hansake/Z80_Computer/hardware/README.md

Useful information about Z80 and its peripherals:
- [Z80 CPU User Manual - um0080.pdf](http://www.zilog.com/docs/z80/um0080.pdf)
- [perip.book - um0081.pdf](http://www.zilog.com/docs/z80/um0081.pdf)

The schematic and component placement is created with KiCad: https://www.kicad.org/
