hansake/Z80_Computer/photos/README.md

Some photos of the Z80 computer board and test environment.
(some photos with the SPI/SD card interface should be added)
