hansake/Z80_Computer/PLD/README.md

The address decoding is done with a Programmable Logic Device (PLD).
The device is ATF22V10C and the logic design is made and simulated
with WinCUPL: https://www.microchip.com/en-us/products/fpgas-and-plds/spld-cplds/pld-design-resources

My setup runs WinCUPL in Wine (https://www.winehq.org/) using PlayOnLinux (https://www.playonlinux.com/en/) on Linux Mint.

To program the ATF22V10C I used a home built device called afterburner described in: https://github.com/ole00/afterburner

PLD programmer: [hansake/PLD_programmer: GAL/PLD programmer used to program Atmel ATF22V10 and ATF16V8.](https://github.com/hansake/PLD_programmer)
