hansake/Z80_Computer/hardware/KiCad/README.md

The design files are exported by KiCad as a zip file.
