hansake/Z80_Computer/photos/Z80_SPI_SD_card_speed.png

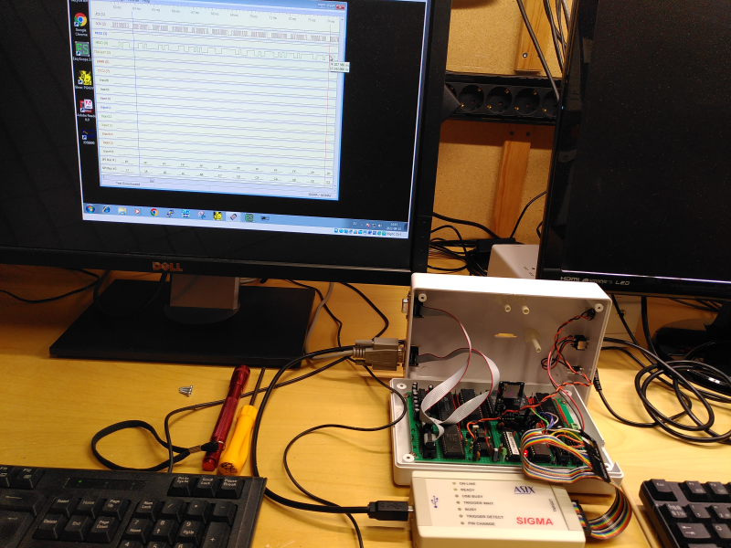
photos/Z80_SPI_SD_card_speed.png
