hansake/Z80_Computer/PLD/Z80_winsim_2021-07-27.png

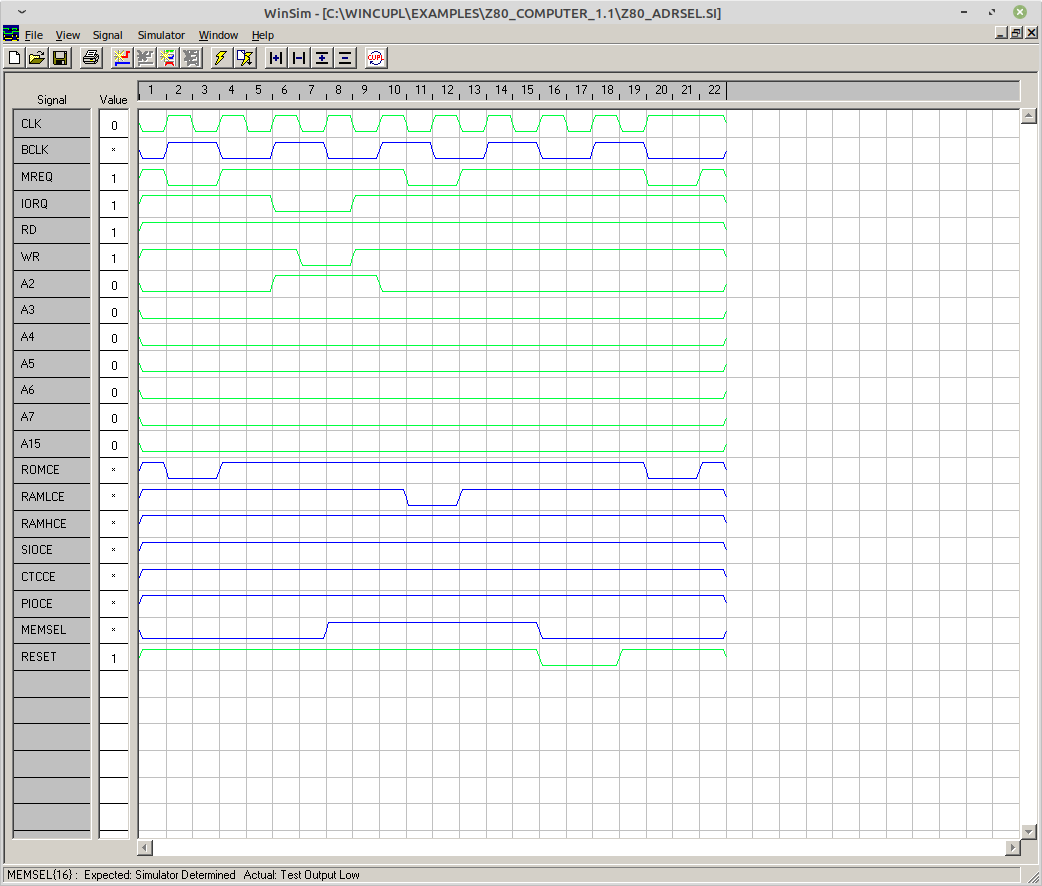
PLD/Z80_winsim_2021-07-27.png
