hansake/Z80_Computer/photos/Z80_SD_tests.png

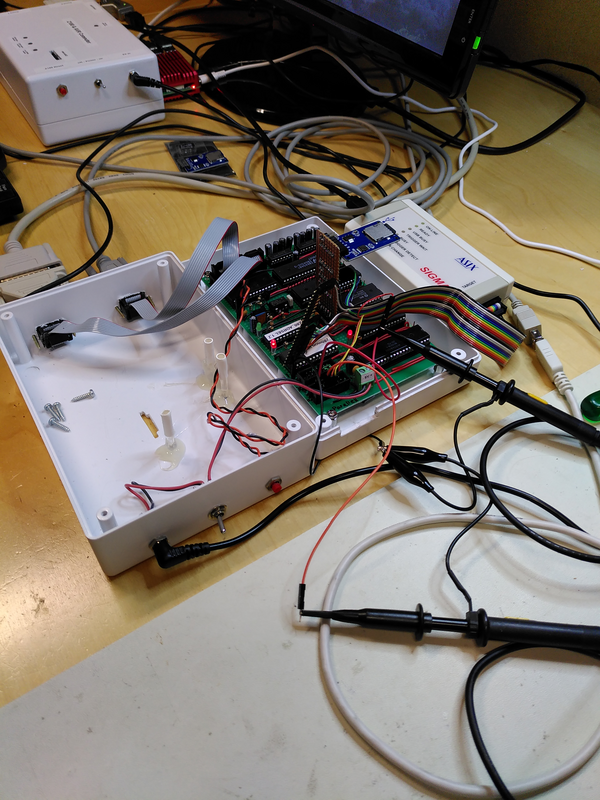
photos/Z80_SD_tests.png
