hansake/Z80_Computer/hardware/Z80_computer_layout.pdf

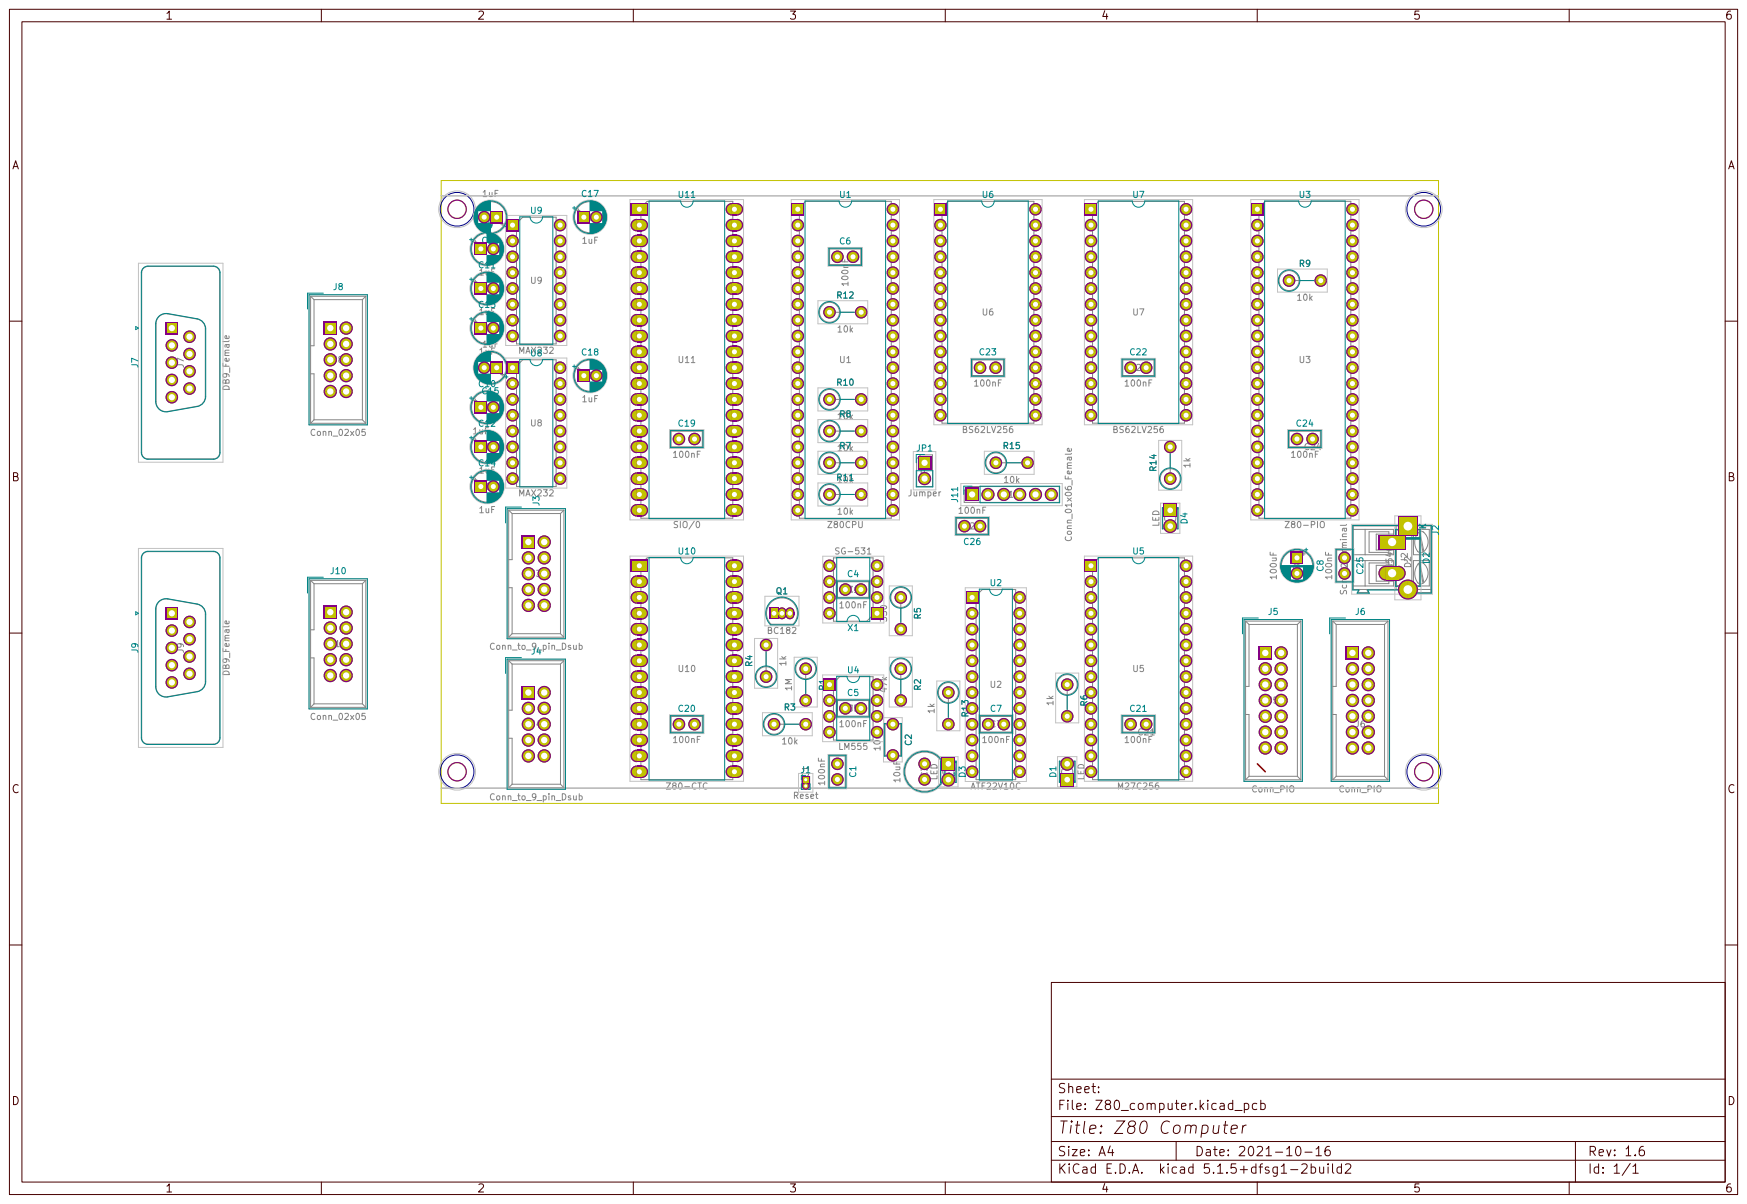
[picture p5: page 1]
