hansake/Z80_Computer/hardware/Z80_computer_schematic.pdf

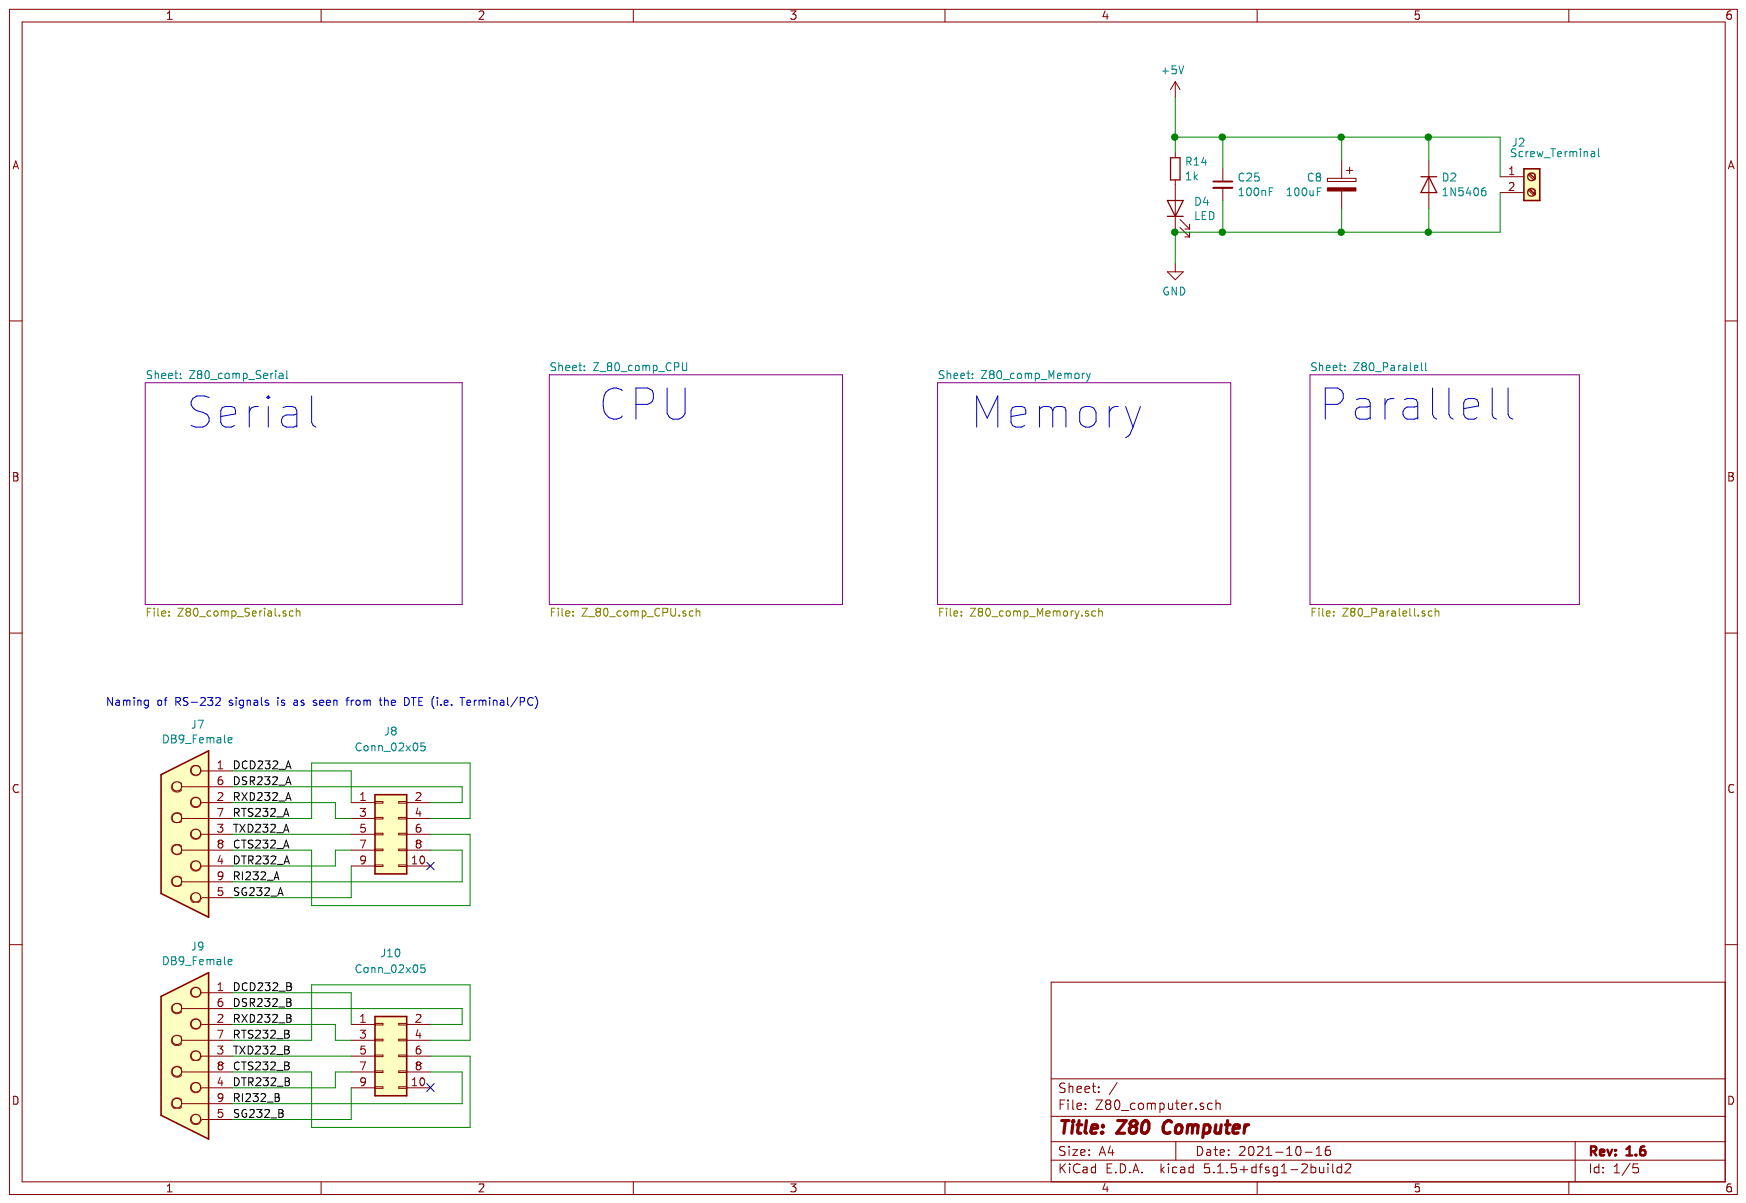
[picture p6: page 1]

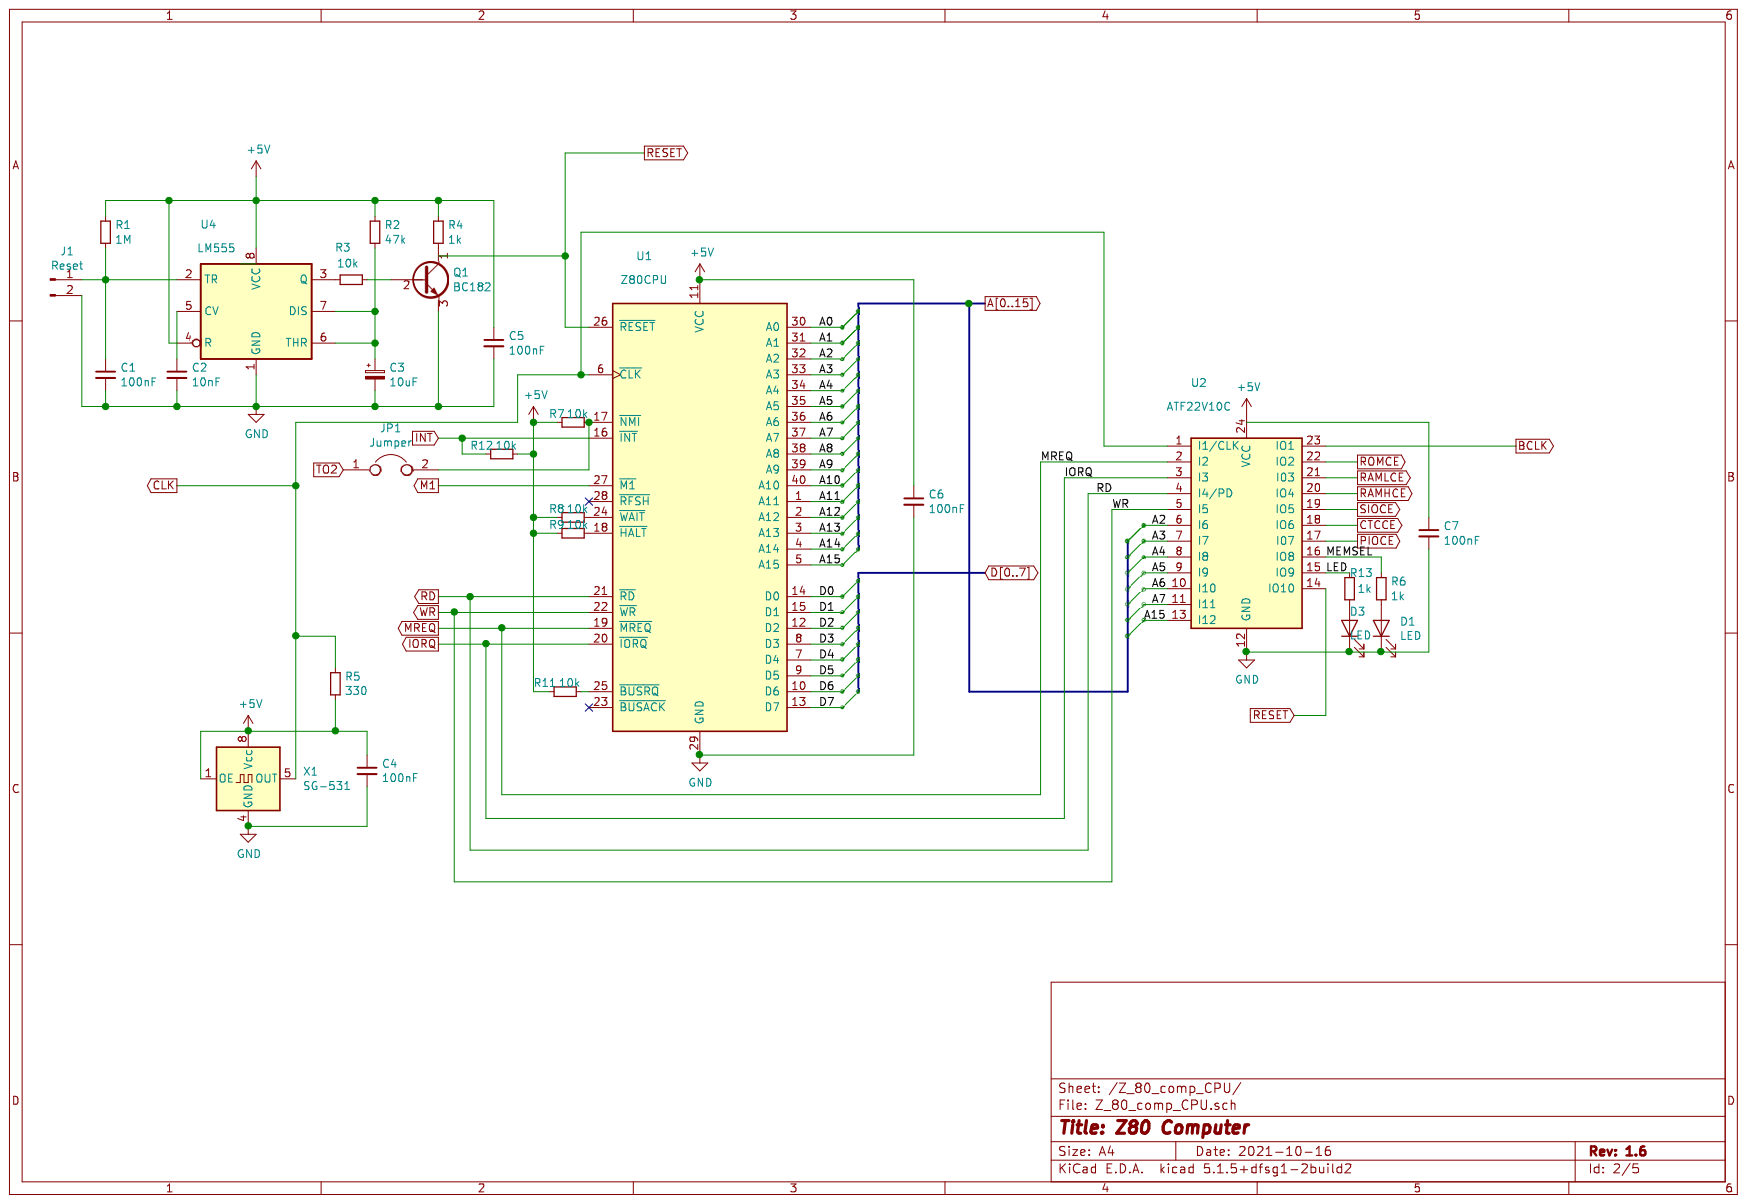
[picture p7: page 2]

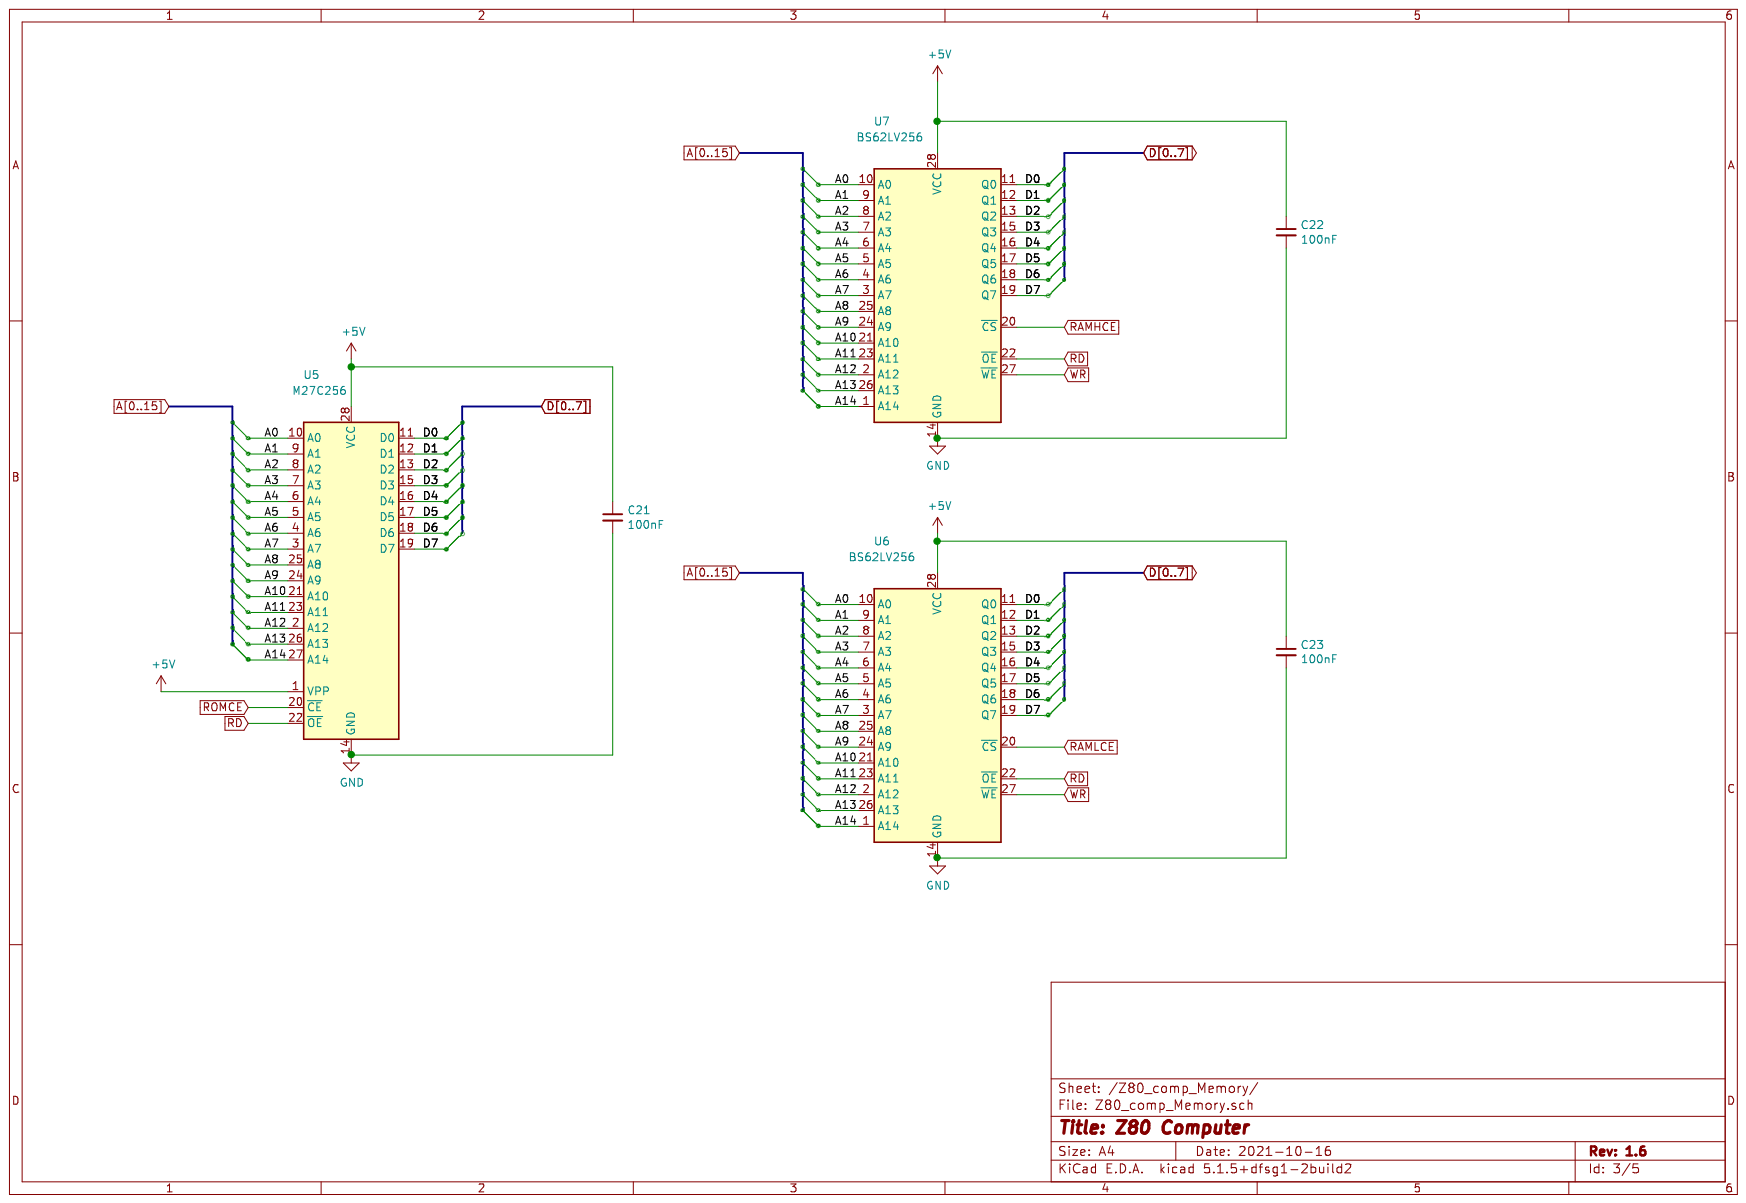
[picture p8: page 3]

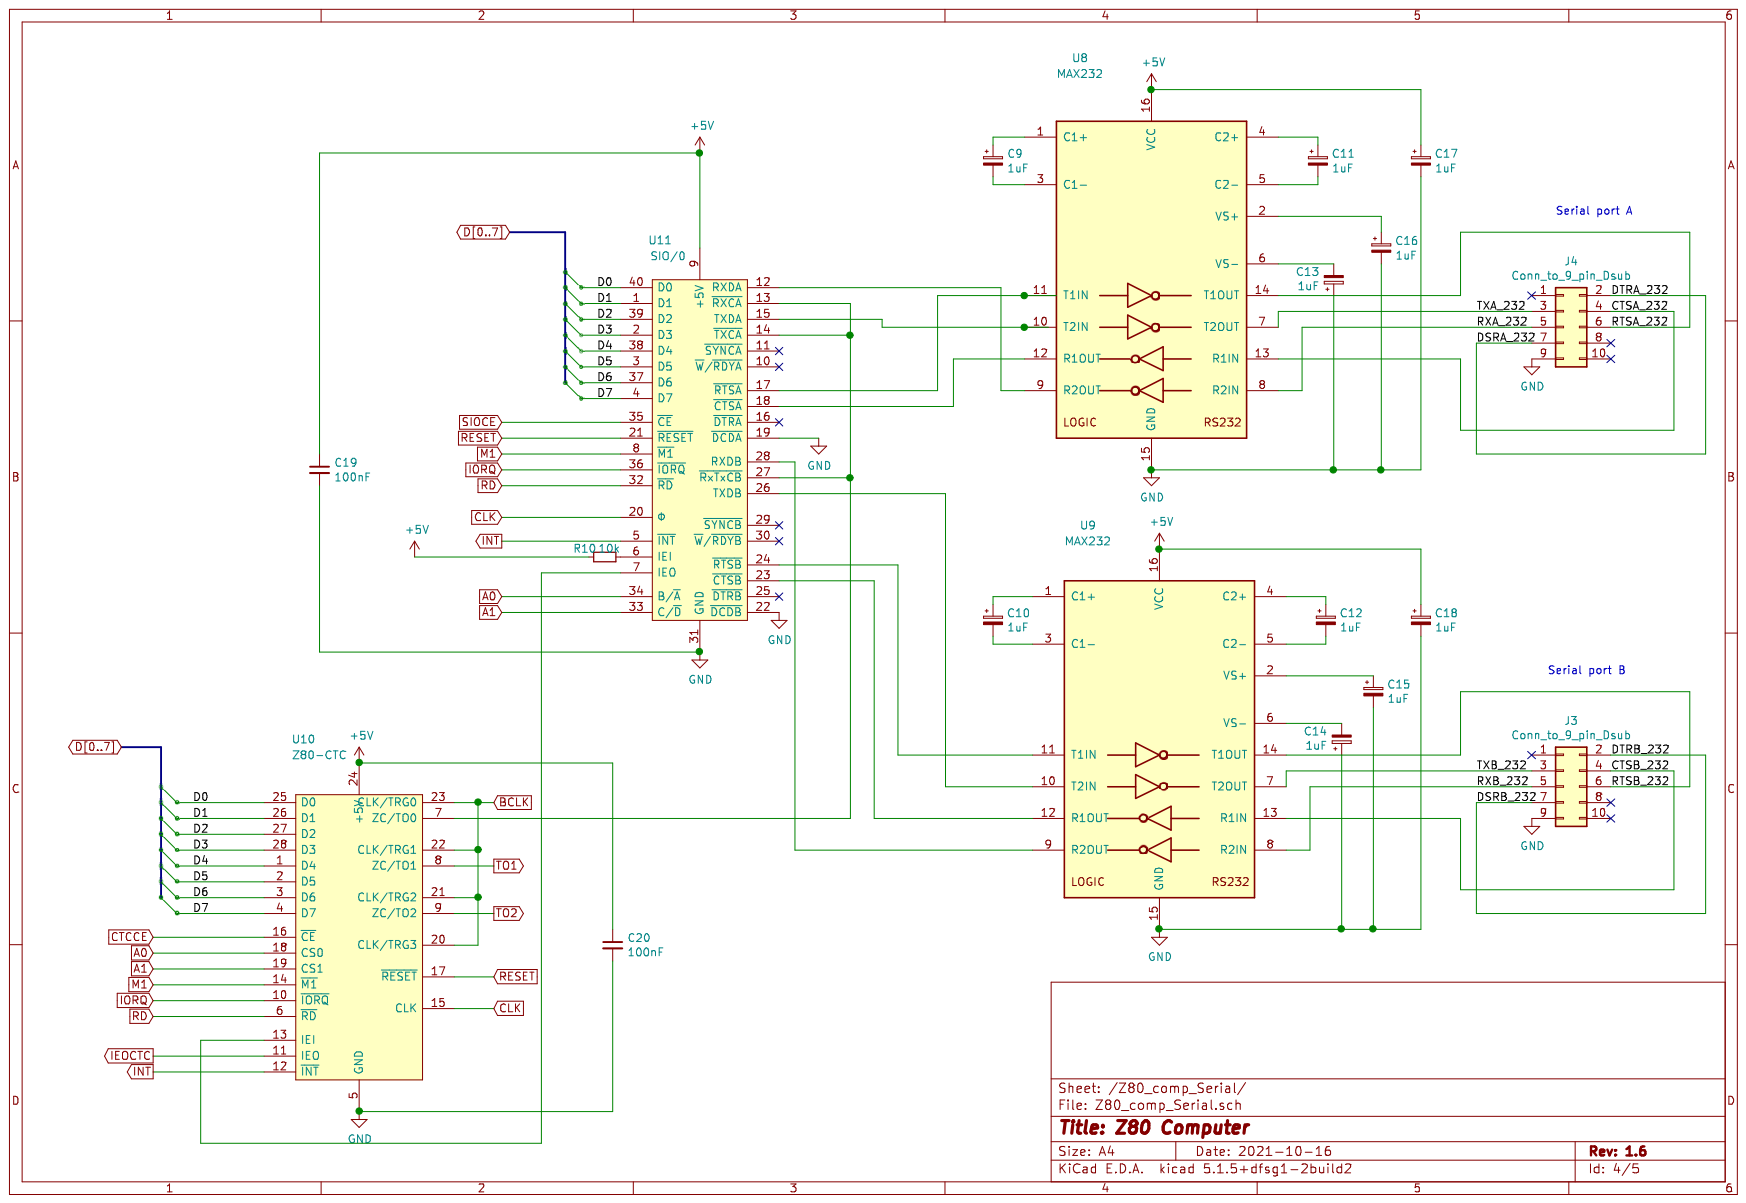
[picture p9: page 4]

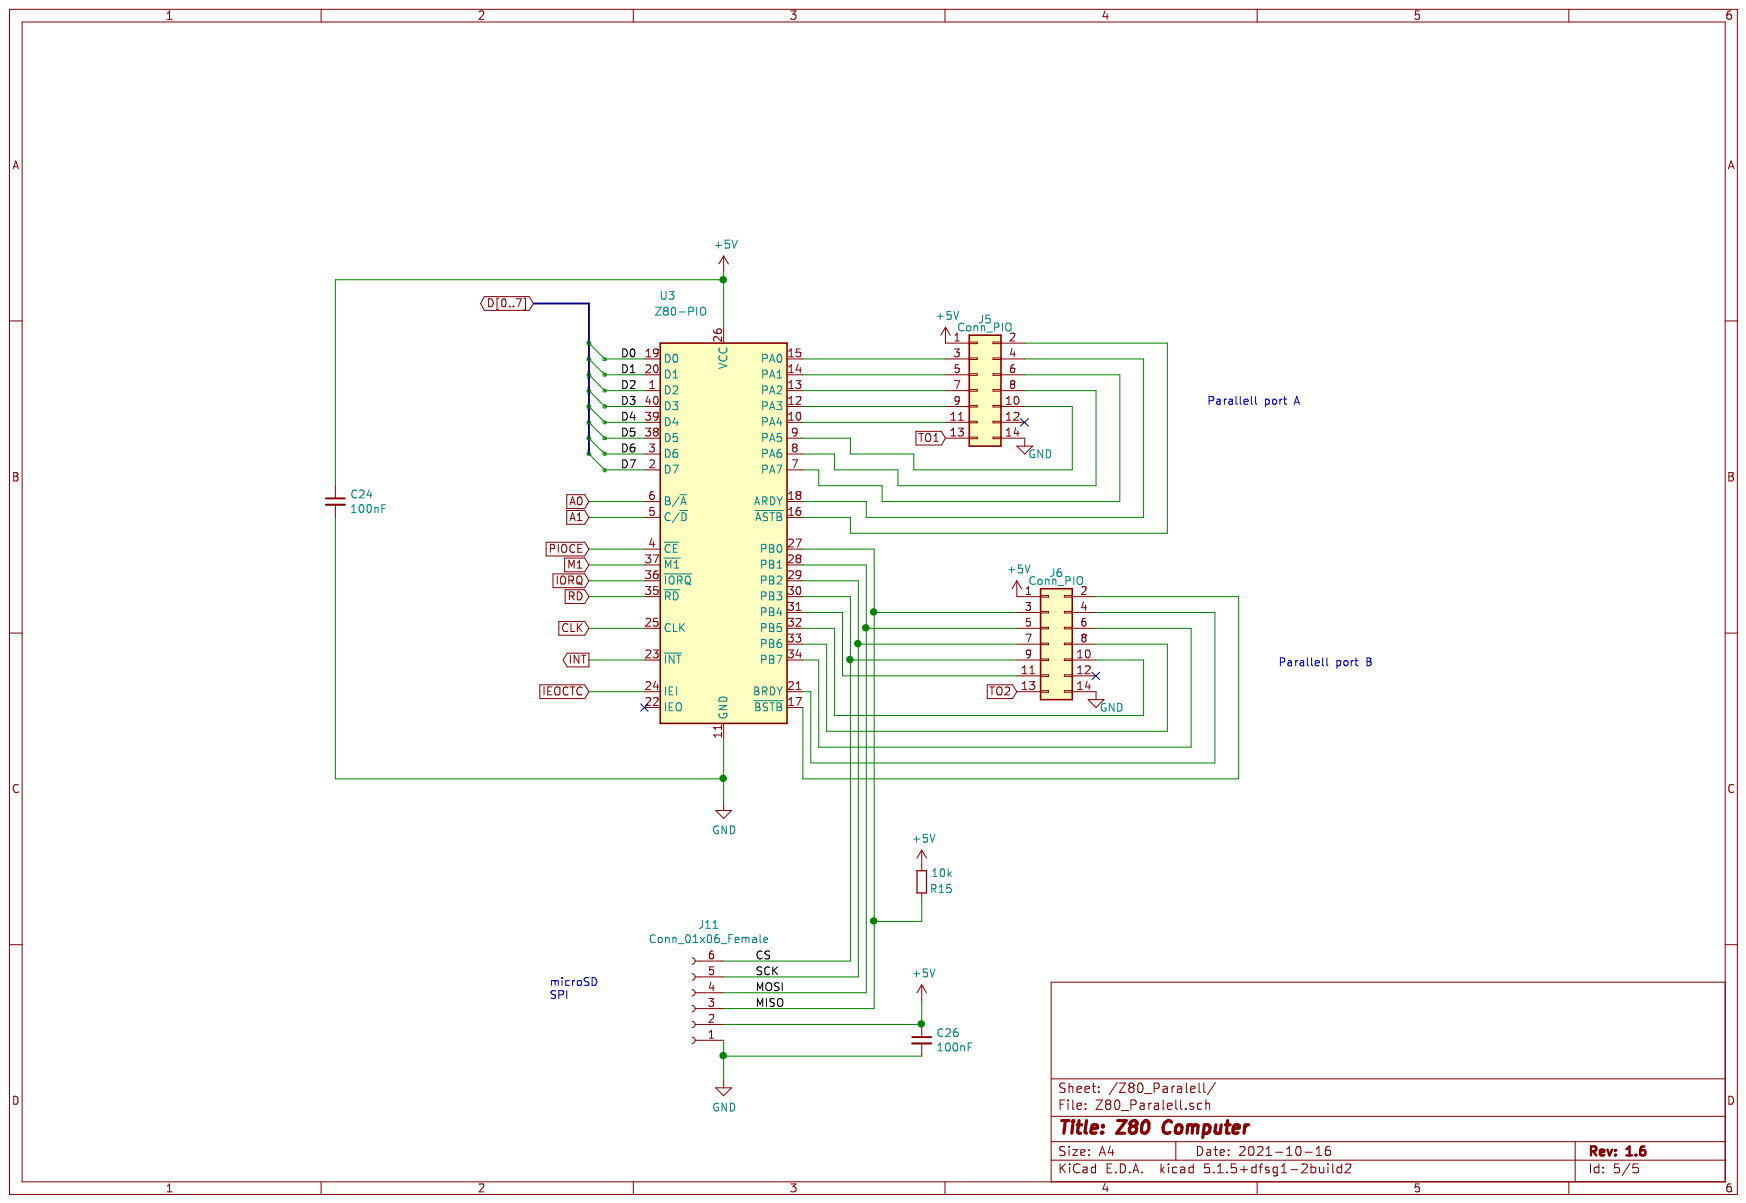
[picture p10: page 5]
