hansake/Z80_Computer/software/sd_boot_test/z80upload.c

/* Created by the bintoc program: Sat Jan 29 15:31:46 2022
 * Input file names: z80upload.bin, 
 * Output file name: z80upload.c
 * Byte array name: upload
 * Variable with size of byte array: upload_size
 */
const unsigned char upload[] = {
    0xc3, 0x24, 0xf0, 0x3e, 0x03, 0xd3, 0x0e, 0xd3, 0x00, 0xc3, 0x00, 0x00, 
    0x7a, 0x38, 0x30, 0x75, 0x70, 0x6c, 0x6f, 0x61, 0x64, 0x20, 0x76, 0x65, 
    0x72, 0x73, 0x69, 0x6f, 0x6e, 0x20, 0x32, 0x2e, 0x30, 0x0d, 0x0a, 0x00, 
    0x31, 0xfe, 0xef, 0xd3, 0x14, 0xf3, 0xd3, 0x04, 0xcd, 0x36, 0xf3, 0x21, 
    0x0c, 0xf0, 0xcd, 0xc8, 0xf3, 0x21, 0x55, 0xf0, 0xcd, 0xc8, 0xf3, 0xcd, 
    0x7c, 0xf3, 0xfe, 0x75, 0xca, 0xe6, 0xf0, 0xfe, 0x67, 0xca, 0x27, 0xf2, 
    0xfe, 0x03, 0xca, 0xfb, 0xf1, 0xfe, 0x74, 0xca, 0x98, 0xf2, 0xc3, 0x29, 
    0xf0, 0x20, 0x20, 0x75, 0x20, 0x2d, 0x20, 0x74, 0x6f, 0x20, 0x75, 0x70, 
    0x6c, 0x6f, 0x61, 0x64, 0x20, 0x66, 0x69, 0x6c, 0x65, 0x20, 0x74, 0x6f, 
    0x20, 0x52, 0x41, 0x4d, 0x20, 0x61, 0x64, 0x64, 0x72, 0x65, 0x73, 0x73, 
    0x20, 0x30, 0x78, 0x30, 0x30, 0x30, 0x30, 0x20, 0x77, 0x69, 0x74, 0x68, 
    0x20, 0x58, 0x6d, 0x6f, 0x64, 0x65, 0x6d, 0x0d, 0x0a, 0x20, 0x20, 0x67, 
    0x20, 0x2d, 0x20, 0x74, 0x6f, 0x20, 0x65, 0x78, 0x65, 0x63, 0x75, 0x74, 
    0x65, 0x20, 0x28, 0x67, 0x6f, 0x29, 0x20, 0x66, 0x72, 0x6f, 0x6d, 0x20, 
    0x52, 0x41, 0x4d, 0x20, 0x61, 0x64, 0x64, 0x72, 0x65, 0x73, 0x73, 0x20, 
    0x30, 0x78, 0x30, 0x30, 0x30, 0x30, 0x0d, 0x0a, 0x20, 0x20, 0x43, 0x74, 
    0x72, 0x6c, 0x2d, 0x43, 0x20, 0x74, 0x6f, 0x20, 0x72, 0x65, 0x6c, 0x6f, 
    0x61, 0x64, 0x20, 0x6d, 0x6f, 0x6e, 0x69, 0x74, 0x6f, 0x72, 0x20, 0x66, 
    0x72, 0x6f, 0x6d, 0x20, 0x45, 0x50, 0x52, 0x4f, 0x4d, 0x0d, 0x0a, 0x2d, 
    0x3e, 0x00, 0x21, 0xb7, 0xf1, 0xcd, 0xc8, 0xf3, 0xd3, 0x04, 0x06, 0x01, 
    0xcd, 0x88, 0xf3, 0x38, 0x07, 0xfe, 0x03, 0xca, 0xae, 0xf1, 0x18, 0xf2, 
    0x21, 0x00, 0x00, 0x22, 0xe3, 0xf3, 0x3e, 0x00, 0x32, 0xe6, 0xf3, 0x3e, 
    0x15, 0xcd, 0x6e, 0xf3, 0x06, 0x03, 0xcd, 0x88, 0xf3, 0x30, 0x0e, 0x06, 
    0x01, 0xcd, 0x88, 0xf3, 0x30, 0xf9, 0x3e, 0x15, 0xcd, 0x6e, 0xf3, 0x18, 
    0xeb, 0xfe, 0x01, 0x28, 0x0c, 0xfe, 0x03, 0xca, 0xae, 0xf1, 0xfe, 0x04, 
    0xca, 0x95, 0xf1, 0x18, 0xe2, 0x06, 0x01, 0xcd, 0x88, 0xf3, 0x38, 0xdb, 
    0x57, 0x06, 0x01, 0xcd, 0x88, 0xf3, 0x38, 0xd3, 0x2f, 0xba, 0x28, 0x02, 
    0x18, 0xcd, 0x7a, 0x32, 0xe5, 0xf3, 0x0e, 0x00, 0x21, 0xe7, 0xf3, 0x16, 
    0x80, 0x06, 0x01, 0xcd, 0x88, 0xf3, 0x38, 0xbb, 0x77, 0x81, 0x4f, 0x23, 
    0x15, 0x20, 0xf2, 0x51, 0x06, 0x01, 0xcd, 0x88, 0xf3, 0x38, 0xac, 0xba, 
    0x20, 0xa9, 0x3a, 0xe5, 0xf3, 0x47, 0x3a, 0xe6, 0xf3, 0x3c, 0xb8, 0x28, 
    0x02, 0x18, 0x16, 0x3a, 0xe5, 0xf3, 0x32, 0xe6, 0xf3, 0xed, 0x5b, 0xe3, 
    0xf3, 0x21, 0xe7, 0xf3, 0x01, 0x80, 0x00, 0xed, 0xb0, 0xed, 0x53, 0xe3, 
    0xf3, 0x3e, 0x06, 0xcd, 0x6e, 0xf3, 0xc3, 0x0c, 0xf1, 0x3e, 0x06, 0xcd, 
    0x6e, 0xf3, 0x21, 0x00, 0xf0, 0x2b, 0x3e, 0x4b, 0x77, 0x2b, 0x3e, 0x4f, 
    0x77, 0x21, 0xd2, 0xf1, 0xcd, 0xc8, 0xf3, 0xc3, 0x29, 0xf0, 0x21, 0xe4, 
    0xf1, 0xcd, 0xc8, 0xf3, 0xc3, 0x29, 0xf0, 0x75, 0x70, 0x6c, 0x6f, 0x61, 
    0x64, 0x20, 0x66, 0x69, 0x6c, 0x65, 0x20, 0x75, 0x73, 0x69, 0x6e, 0x67, 
    0x20, 0x58, 0x6d, 0x6f, 0x64, 0x65, 0x6d, 0x0d, 0x0a, 0x00, 0x75, 0x70, 
    0x6c, 0x6f, 0x61, 0x64, 0x20, 0x63, 0x6f, 0x6d, 0x70, 0x6c, 0x65, 0x74, 
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
const int upload_size = 1127;
