hansake/Z80_Computer/software/tools/wsl/include/v30/pat.h

/* HEADER FOR PATTERN MATCHING STUFF
 * copyright (c) 1980 by Whitesmiths Ltd.
 */
#include "stdtyp.h"

#define CCHAR 1 /* literal character */
#define ANY  2 /* any character */
#define SBOL 3 /* beginning of line */
#define SEOL 4 /* end of line */
#define CLOSE 5 /* reflexive closure */
#define CCL  6 /* begin character class */
#define NCCL 7 /* begin negated character class */
#define RANGE 8 /* range within character class */
#define CCLEND 9 /* end of character class */
#define PEND 10 /* pattern end */
#define RPAR 19 /* right parenthesis */
#define LPAR 20 /* left parenthesis */

 /* the substitution structure
  */
typedef struct {
    TEXT *mtext;
    BYTES mlen;
} MSUB;

/* match.c */
BYTES amatch(TEXT *buf, FAST BYTES n, BYTES indx, TEXT *pat, MSUB *pmsub);
BOOL match(TEXT *buf, FAST BYTES n, FAST TEXT *pat);
/* pat.c */
TEXT *pattern(FAST TEXT *pat, TEXT delim, TEXT *p);
