hansake/Z80_Computer/(commit log)

2021-05-26 Pullup resistor on /INT added.
2021-05-29 Added interupt handling test.
    The bit pattern output in PIO channel A and B is updated for each interrupt.
2021-05-29 Logic analyzer showing interrupt.
2021-05-29 CTC chan 3 changed to timer mode.
2021-07-26 The Z80 Computer put in enclosure
2021-09-27 Status LED added.
2021-09-27 Status LEDs and SD/SPI interface added.
2021-09-27 SD memory card using SPI was added
2021-10-30 SPI CD card test program added
2021-10-30 SPI SD card interface added.
2021-10-30 added pullup on SPI MISO signal
2022-01-07 z80sdtst updated to use printf
2022-01-27 added program printout
2022-01-29 updated printout
2022-08-15 SPI speed measurement
